Typwithoutname/VMCB/Git-Guide.txt

Wichtigster Befehl: "git status"

1.Projekt auf deinen PC clonen

-In den Ordner gehen in das du Clonen willst
-Linksclick "Git Bash"

-Commando eingeben "git init"
-"git pull https://github.com/Typwithoutname/VMCB"

Jetzt sollte das Projekt im localen Ordner sein

--------------------------------------------------------

2.Die Githubseite updaten
-In den Ordner gehen den du updaten willst
-Linksclick "Git Bash"

-"git add --all"
-"git commit"
VIM
"i" drücken dann kann Text eingefügt werden
Text eingeben
drücke "ESC" 
Eingeben von ":x"

-"git add -u"
-"git push https://github.com/Typwithoutname/VMCB"

--------------------------------------------------------

3.Lokales Projekt updaten
Bevor du anfängst immer das hier machen
-In den Ordner gehen den du updaten willst
-Linksclick "Git Bash"

-"git pull https://github.com/Typwithoutname/VMCB"
