Typwithoutname/VMCB/Endpräsentation.pptx

- Stimmungsampel

## Slide 2

- Gliederung

- Projektvorstellung
- STM32G031J6M6
- LED‘s
- Kapazitiver Sensor
- Energiesparmodus
- Schaltplan und Layout

## Slide 3

Vorlagen PPT der OTH Regensburg - Format 16x9

- Funktionalität

## Slide 4

- STM32G031J6M6

- Was kann er?
- Core: ARM 32-Bit Cortex –M0+ CPU
- Power: 1.7 to 3.6V
- 4 oscillator
- DMA controller
- ADC
- 11 timers
- communication interfaces

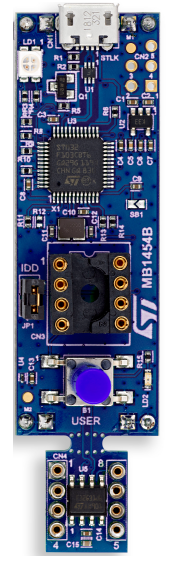
[picture p11: figure]

## Slide 5

- LED‘s

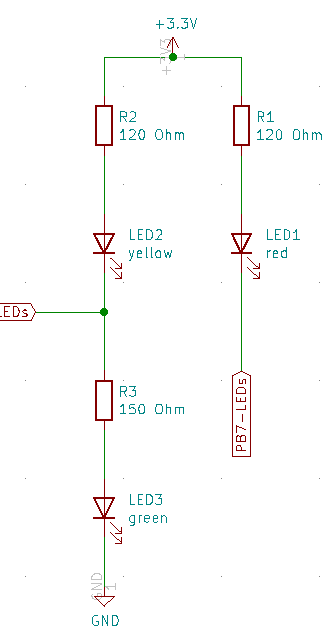
[picture p12: figure]

- RGB-LED‘s
- WS2812b
- Versorgung 5V -> Boost Converter
- DMA Auslesung
- PWM Ansteuerung seriell
- Led-Schaltung
- Ansteuerung mehrerer LED‘s mit wenig Pins

1

2

## Slide 6

- Funktionalität kapazitiver Sensor mit Gehäuse

## Slide 7

- Schaltplan

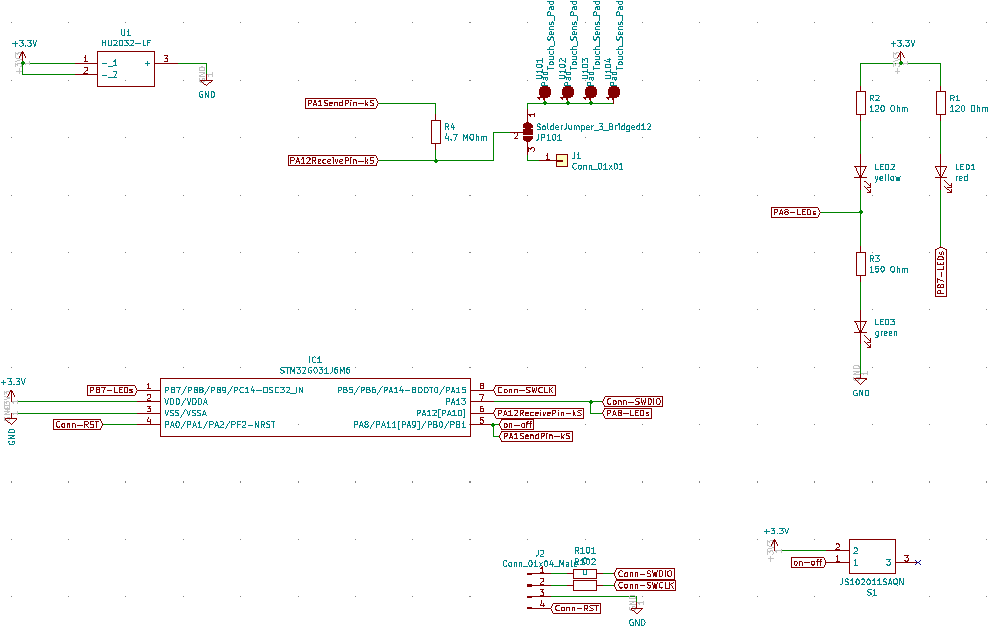
[picture p13: figure]

Batterieversorgung

Kapazitiver Sensor

LED-Schaltung

Mikrocontroller

Schalter für Lowpowermode

Connector zum Debuggen

## Slide 8

- Layout – Bauteile

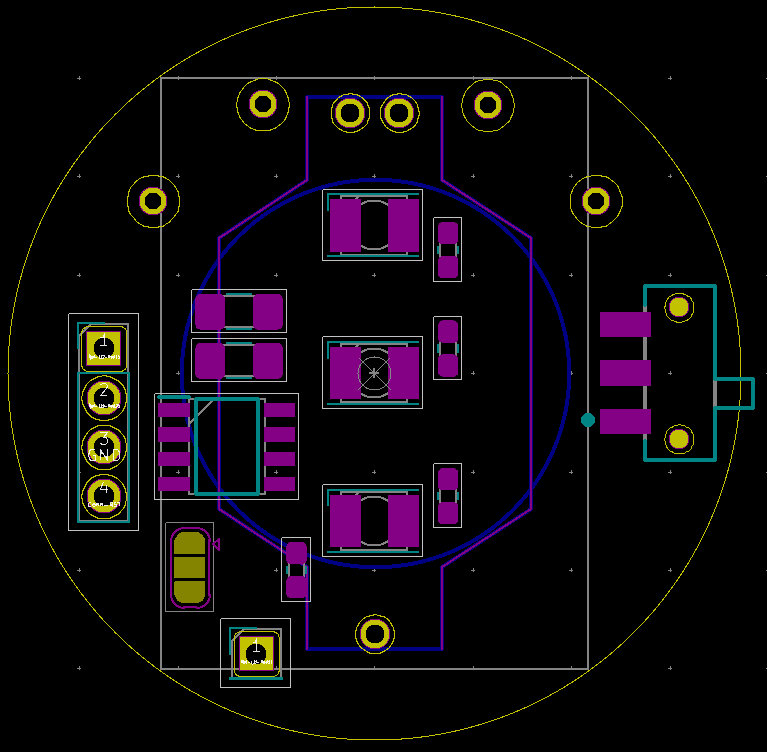
[picture p14: figure]

Batterieversorgung
Mikrocontroller
Connector zum Debuggen
Schalter für Lowpowermode
Kapazitiver Sensor
LED-Schaltung

## Slide 9

- Layout

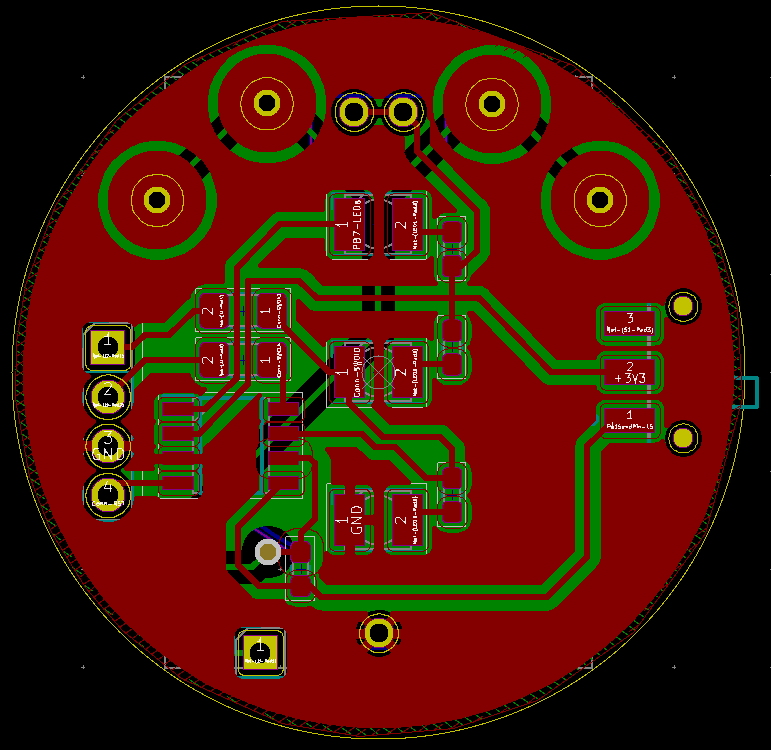
[picture p15: figure]
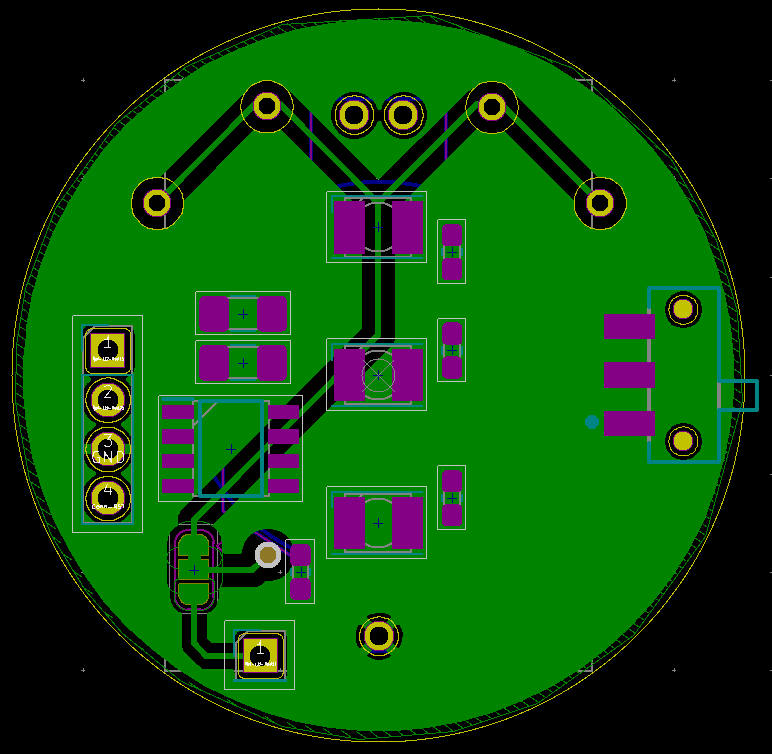
[picture p16: figure]

## Slide 10

- Gefräste Platine

## Slide 11

- Gehäuse

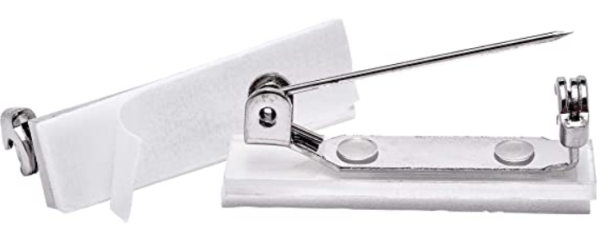
[picture p17: figure]
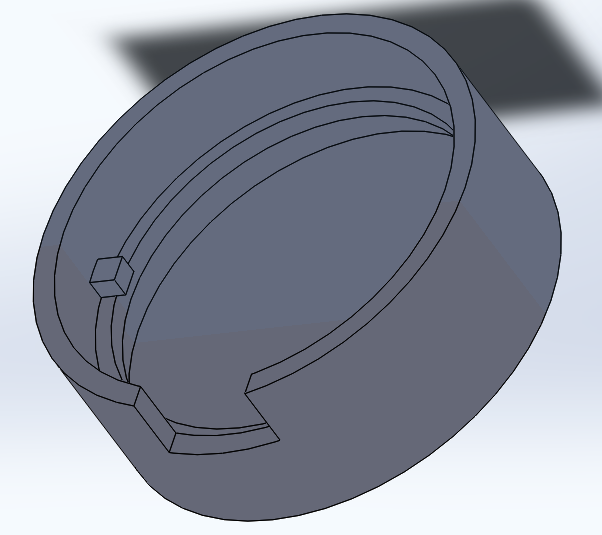
[picture p18: figure]
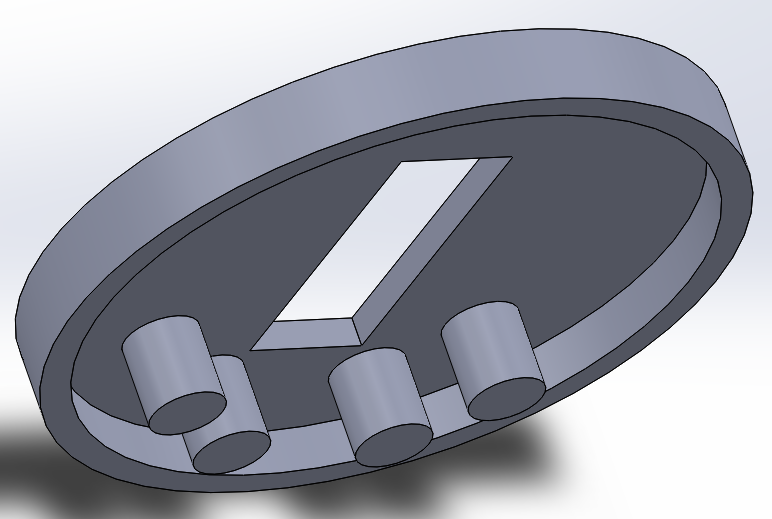
[picture p19: figure]

## Slide 12

- Gedrucktes Gehäuse
