Typwithoutname/VMCB/Doku/AblaufMain.docx

Nein

Nein

Nein

Ja

Ja

Ja

Weiterschalten LED-Zustand

Berührung festgestellt?

Stoppen des Energiesparmodus

Energiespar-modus noch an?

Auslesen von Kapazitiver Sensor

Einschalten des Energiesparmodus

Energiesparmodus an?

Init

Start
