Typwithoutname/VMCB/Doku/Zustandsdiagramm.docx

Schalter Aus

Schalter Aus

Schalter Aus

Schalter Aus

Schalter An

Schalter An

Schalter An

Schalter An

Berührung

Berührung

Berührung

Berührung

Energiesparmodus – LED-Grün

Energiesparmodus – LED-Gelb

Energiesparmodus – LED-Rot

Energiesparmodus – Keine LED

Keine LED

LED-Rot

LED-Gelb

LED-Grün
