Typwithoutname/VMCB/Doku/BA.pdf

714

1

# Stimmungsampel

### Luzia Pfeilschifter und Felix Maier

### 30. Dezember 2020

2

Zusammenfassung

Das Ziel des Projektes war es ein minimalistisches Gerät mit dem STM32G031-Microcontroller zu entwickeln, welches die Stimmung des Trägers mithilfe von LED’s darstellt und dabei party-tauglich ist. Aus diesem Vorgaben ist das entwickelte Gerät entstanden. Es wird mit einer Knopfzelle betrieben und lässt sich durch eine Beruhrung ¨ mit dem Finger an der Vorderseite des Gehäuses zyklisch, wie eine normale Ampel, weiter schalten. Dies wird durch einen kapazitiven Sensor ermöglicht. Außerdem ist noch ein Schalter verbaut, der die ”

Stimmung“ einrasten lässt um beispielsweise ein versehentliches Weiterschalten beim Tanzen zu verhindern. Zudem ermöglicht dieser Schalter eine Reduktion des Stromverbrauchs, wodurch der Partyspaß noch länger anhält.

3

## Inhaltsverzeichnis

1 Funktionsweise | 5
2 Microcontroller | 7
3 LED | 9
3.2.2 | grune LED | ¨ | 11
3.3 Auswahl der Widerstände fur die LED-Schaltung | ¨ | 12
4 Kapazitiver Sensor | 14
5 Energiesparmodus | 18
6 Schaltplan und Layout | 19
7 Gehäuse | 25
8 Fazit | 30

4

## 1 Funktionsweise

Die Funktionsweise werden durch die Abbildung 1 und 2 dargestellt.


Abbildung 1: Flussdiagramm zum Ablauf des Hauptprogramms

5


Abbildung 2: Zustandsdiagramm

6

## 2 Microcontroller

7


Abbildung 3: STM32G031J6M6 als SMD-Baustein QUELLE

Das Projekt wurde mit dem STM32G031J6M6 (Abbildung 3) umgesetzt. Dies ist ein 8-Pin Microcontroller mit einer ARM 32-Bit Cortex–M0+ CPU, der sehr wenig Strom verbraucht und damit perfekt fur diesen Einsatzbereich ¨ ist. Er kann mit 1.7 V bis 3.6 V betreiben werden, was gut fur die Versorgung ¨ mit eine Knopfzelle ist.
Zudem verfugt er ¨ uber 4 Oszillatoren, einen DMA-controller, einen ADC, 11 ¨ Timer und verschiedene Kommunikationsinterfaces, was völlig ausreichend fur dieses Projekt ist QUELLE. ¨
Dieser Mikrocontroller hat aber auch Nachteile: Einerseits die Pin-Knappheit, da nur 6 Pins programmiert werden können, was die Komplexität der Außenbeschaltungen einschränkt. Die Pinbelegung zeigt hierbei Abbildung 4.
Andererseits kann es schwer sein diesen Microcontroller zu debuggen bzw. zu flashen, da die Pins 7 und 8 umprogrammiert werden können und somit
nicht mehr fur der Debug- bzw. Flashvorgang zur Verf ¨ | ugung stehen. Dieses ¨
Problem wurde mithilfe des Programmes STM32 ST-LINK Utility, welches eine ”

Connect under Reset“-Option besitzt, gelöst. Dabei wird der Controller in den Reset-Zustand gebraucht. Beim Austreten aus diesen Zustand verbindet es sich mit dem Mikrocontroller bevor der bereits bestehende Code ausgefuhrt wird, was es erlaubt den Baustein neu zu programmieren. ¨

Abbildung 4: Pinbelegung des Mikrocontrollers STM32G031J6M6 QUELLE

8

## 3 LED

### 3.1 WS2812b

Als nächstes wird die Möglichkeit betrachtet eine WS2812b-LED zu verwenden. Sie hat von allen bisherigen LED’s die größte Variation an Farben, die dargestellt werden können. Die Ansteuerung erfolgt außerdem nur uber eine ¨ Datenverbindung, was bei einem Mikrocontroller mit nur 8 Pins sehr vorteilhaft ist.
Die verschiedenen Ubertragungsbit k ¨ | önnen dabei als PWM-Signale mit un-
terschiedlichen Duty-Cycle aufgefasst werden. So hat eine logische ”
| 0“ ein
Duty-Cycle von 32% und eine logische ”
| 1“ ein Duty-Cycle von 68%.
Daraus können GRB-Werte gebildet werden, welche durch ein DutyCycle
von 0% uber mindestens 50 ¨ | µs von den LED’s ubernommen werden. Die- ¨
ser komplette Vorgang ist sehr aufwändig fur den Prozessor. Deshalb wird ¨ der im Mikrocontroller eingebaute DMA-Controller, was fur ¨
| ” Direct Memo-
ry Access“ steht, verwendet, um die Auslastung des Prozessors signifikant zu verbessern.
Die WS2812b LED hat aber insgesamt zwei große Nachteile, die sie schlechter als andere Varianten macht. Zum einen die hohen Kosten, was mit dem Ziel einen möglichst preiswerten Aufbau zu entwerfen kollidiert. Und zum anderen benötigt sie Spannungsversorgung von 5 V, was einen Hochsetzsteller erfordern wurde, da der komplette Aufbau mit einer Knopfzelle betrieben ¨ wird.

9

### 3.2 LED-Schaltung


Abbildung 5: LED Schaltung

Letztendlich war eine Schaltung, die mit möglichst wenig Pins möglichst viele LED’s ansteuert am sinnvollsten. Um dies zu ermöglichen wurde eine Schaltung entworfen, die mit Hilfe von Input und Output die LED’s steuert. Dabei können bis zu 4 LED’s mit 2 Pins angesteuert werden. In der vorliegenden Ampelschaltung sind nur 3 LED’s notwendig, allerdings könnte die 4. noch zwischen Ground und LED1 gehängt werden, wie parallel dazu LED3. Also gibt es 4 verschiedene Zustände, die im folgenden erklärt werden:

10

### 3.2.1 keine LED leuchtet

Der Pin ”

PA8-LEDs“ wird als Input deklariert, so fließt im linken Zweig kein Strom. Wenn nun auch noch ”

PB7-LEDs“ auf Input gesetzt wird, wird auch dieser Pin hochohmig und im rechten Zweig fließt kein Strom. Wenn weder im linken noch im rechten Zweig ein Stromfluss entsteht sind alle LED’s aus.

### 3.2.2 grune LED ¨

Indem der Pin ”

PA8-LEDs“ als Output auf ”
HIGH“ gelegt wird, fließt Strom zwischen ”

HIGH“ und Ground → LED3 leuchtet. Um die rote LED nicht zu aktivieren, wird ”

PB7-LEDs“ als Input gesetzt und wiederum hochohmig. Die gelbe LED leuchtet nicht, da kein Spannungsfall zwischen 3.3 V und

”

PA8-LEDs“ vorhanden ist.

### 3.2.3 gelbe LED

Um die gelbe LED2 leuchten zu lassen wird nun der Pin ”

PA8-LEDs“ als
Output auf ”

LOW“ gesetzt. Die Folge ist, dass Strom zwischen 3.3 V und

”

PA8-LEDs“ fließt → LED2 leuchtet. Um zu erreichen, dass auch nur LED2 leuchtet wird ”

PB7-LEDs“ als Input gesetzt und somit hochohmig → im rechten Zweig fließt kein Strom.

### 3.2.4 rote LED

Der Pin ”

PB7-LEDs“ wird als Output auf ”

LOW“ gesetzt. Dadurch fließt ein Strom zwischen 3.3 V und dem Output ”

LOW“ → LED1 leuchtet. Damit die anderen LEDs nicht leuchten, wird ”

PA8-LEDs“ auf Input gesetzt, dadurch wird er hochohmig und im linken Zweig fließt kein Strom.
Dies ist in der folgenden Tabelle 3.2.4 noch einmal zusammenfassend dargestellt.
Leuchtet | Zustand | PA8-LEDs | PB7-LEDs
keine LED | aus | IN | IN
LED1 | grun¨ | OUT−HIGH | IN
LED2 | gelb | OUT−LOW | IN
LED3 | rot | IN | OUT−LOW

Tabelle 1: LED Schaltung Pinbelegung

11

### 3.3 Auswahl der Widerstände fur die LED-Schaltung ¨

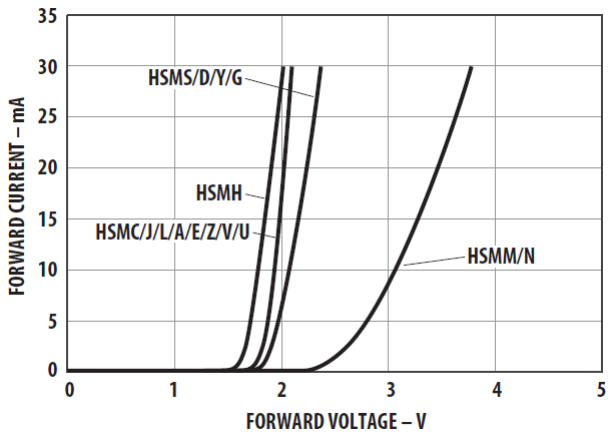
[picture p25: figure]

Abbildung 6: Kennlinien forward current vs. forward voltage der unterschiedlichen SMD-LED’s [1]

Anhand dem Bestand im Labor der OTH, fiel die Entscheidung auf die Widerstandsreihe R0603. Auch die Auswahl der LED’s erfolgte nach diesem Kriterium fur die HSMx-A100-Reihe von Avago. ¨
Hierbei ergeben sich aus dem Datenblatt unterschiedliche forward voltage fur ¨ die jeweilige Leuchtfarbe. Die Berechnung der Widerstände erfolge allerdings immer nach demselben Prinzip. Dabei wurde zunächst die jeweilige forward voltage ermittelt und anschließend mit der Batterieversorgung von 3.3 V und einem gewunschten Strom von 10 mA der resultierende Widerstand berech- ¨ net.
Die Festlegung auf 10 mA erfolgte vor allem aus Erfahrung und aus Grunden ¨ des Stromverbrauchs. Der normale Betrieb liegt bei 20 mA, dies ist allerdings recht hell und bei einer meist dunklen Party erschienen somit auch 10 mA
ausreichend, was gunstiger f ¨ | ur den Stromverbrauch ist. ¨

12

Bei der roten LED1 handelt es sich um eine HSMS-A100-J00J1. Mit dieser Information lässt sich die entsprechende Kennlinie und damit die resultierende forward voltage von 2.1 V ermitteln. Die folgende Berechnung fur den ¨ Vorwiderstand ist also:

R1 = (3.3 − 2.1)V/10mA = 120Ω

Als letztes muss noch uberpr ¨ uft werden, ob dieser Wert auch innerhalb der ¨ R0603-Reihe vorhanden ist oder ob ein naheliegender Wert gewählt werden muss. Da allerdings 120 Ω vorkommen, kann der exakte Wert fur die Schal- ¨ tung verwendet werden.

Die selben Schritte erfolgen nun auch fur die weiteren LED’s, wodurch sich ¨ fur die gelbe LED2 (HSMY-A100-J00J1) dieselbe forward voltage ergibt. ¨ Dadurch ist nun die Berechnung gleich der Rechnung fur die rote LED: ¨

R2 = (3.3 − 2.1)V/10mA = 120Ω

Und auch hier kann direkt der richtige Wert aus der Reihe genommen werden.

Zum Schluss noch zur grunen LED3, dem Bauteil HSME-A100-L01J1. Hier ¨ lässt sich eine forward voltage von 1.8 V aus dem Diagramm ablesen. Dadurch ergibt sich fur den Widerstand: ¨

R3 = (3.3 − 1.8)V/10mA = 150Ω

Nach der Reihe R0603 ergibt das auch einen Widerstand von 150 Ω.

13

## 4 Kapazitiver Sensor

Als nächstes wird der Kapazitive Sensor erläutert, der fur die Weiterschaltung ¨ der LED’s zuständig ist. Grundsätzlich ist zu sagen, dass alle Kapazitiven Sensoren auf einem RC-Oszillator basieren. Kommt es zu einer Beruhrung ¨ oder Näherung durch beispielsweise einem Finger so wird die Kapazität und somit die Lade- und Entladezeit des Oszillators erhöht. Es gibt verschiedene Möglichkeiten dies zu detektieren. Nachfolgend sind einige davon aufgelistet, die fur das Projekt in Betracht gezogen wurden. ¨

### 4.1 Verschiedene Varianten von Kapazitiven Sensoren

### 4.1.1 Komparator

Zuerst wird die Komparator-Methode erklärt. Hierbei wird ein Dreieck-Signal an einem RC-Ladeglied angelegt. Durch das RC-Glied wird das Signal abgerundet ähnlich wie in Abbildung ?? zu sehen. Dieses Signal und eine feste Gleichspannung wird nun an einen Komparator angelegt. Jedes Mal wenn der Komparator umschaltet wird die vergangene Zeit gemessen. Gibt es
eine Beruhrung so wird das Dreieck-Signal st ¨ | ärker abgerundet und somit
verändert sich auch die Zeit die der Komparator zum Umschalten braucht. Durch dieses Prinzip können auch relativ elegant Timer und Interrupts verwendet werden.

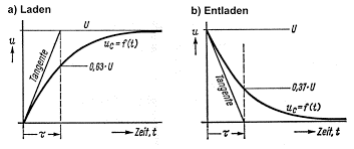
[picture p26: figure]

Abbildung 7: RC-Tiefpass

14

### 4.1.2 ADC

Als nächstes wird die Variante erklärt, die einen Analog-Digital-Wandler verwendet. Hierbei wird ein RC-Ladeglied auf den logischen High-Pegel aufgeladen und nach einer festen Zeit mithilfe des ADC gemessen. Die gemessene Spannung ist dabei abhängig von der Kapazität des Ladeglieds. Ist die
Kapazität nicht erhöht, also keine Beruhrung oder N ¨ | äherung von zum Bei-
spiel einem Finger, so entlädt sich die Spannung schneller. Gibt es aber eine
Beruhrung oder N ¨ | äherung so ist die Kapazität höher und die Entladekon-
stante des RC-Glieds größer, was zu einem zeitlich längeren Spannungsabfall
fuhrt. Zusammengefasst ist also die Spannung, die der ADC misst gr ¨ | ößer
wenn eine Beruhrung oder N ¨ | äherung statt gefunden hat.

### 4.1.3 Sende- und Empfangspins

Die dritte Variante ist jeweils einen Sende- und Empfangspin zu benutzen. Dabei wird ein sehr hochohmiger Widerstand zwischen zwei Pins gesetzt, der mit der Kapazität des Receivepins ein RC-Tiefpass realisiert. Verändert man nun den Logik-Pegel am Sendpin so dauert es, wegen dem Tiefpass, eine kurze Zeit bis diese Anderung am Receivepin ankommt. Diese Zeit ist messbar und ¨ je nach Kapazität unterschiedlich. Die unterschiedliche Kapazität ist auf ein
Metallstuck oder Folie, welches am Receivepin befestigt ist, zur ¨ | uckzuf ¨ | uhren. ¨
Beruhrt man diese Folie so wird, wie bei der ADC-Variante, die Ladekonstan- ¨ te erhöht und es dauert länger bis eine Anderung des Sendpins am Receivepin ¨ erkannt wird. Dieser Aufbau ist im Abbildung 8 veranschaulicht.


Abbildung 8: Funktionsweise des Kapazitiven Sensors

15

### 4.2 Bewertung

Als nächstes werden die Varianten aus 4.1 bewertet. Die erste Lösung ist hier sehr umständlich umzusetzen, da der Mikrocontroller STM32G0316J6M6 keinen Komparator besitzt. Deswegen wurde diese Variante nicht verwendet. Die ADC-Methode hat den großen Vorteil, dass sie nur ein Pin benötigt. Sie braucht jedoch eine zusätzliche Kapazität, was Platz verbraucht und Kosten verursacht. Zudem besitzt der Mikrocontroller nur einen Analog-Digital-
Wandler, welcher gegebenenfalls anderweitig fur einen Sensor h ¨ | | ätte verwen-
det werden können. Die letzte Variante ist auch die Einfachste. Sie braucht nur einen Widerstand und hat keine besonderen Anforderungen an die Hardware des Mikrocontrollers. Der größte Nachteil ist hier allerdings, dass zwei Pins benötigt werden. Pins können aber trotzdem mehrfach verwendet werden, was in 5 näher erklärt wird. Letztendlich wurde sich fur die Sende- und ¨ Empfangsmethode entschieden.

### 4.3 Umsetzung

Dieser Abschnitt beinhaltet die Umsetzung der Variante, welche unter 4.2 ausgewählt wurde. Grundsätzlich ist zu sagen, das der Sensor in der jetzigen Form sehr ungenau und unzuverlässig ist. Um dies zu ändern und eine auswertbare Messung zu erhalten muss der Vorgang mehrfach hintereinander durchgefuhrt werden, damit eventuelle Fehlerquellen ermittelt und behoben ¨ werden können.
Ein großes Problem ist zudem, dass der Receivepin nach einer einzelnen Messung nicht auf einen vollen HIGH- bzw. LOW-Pegel aufgeladen wird, was
schlecht fur die n ¨ | ächste Messung wäre.
Der Receivepin meldet also einen HIGH-Pegel schon bei beispielsweise 1.8
V, was das Ende der Messung bedeuten wurde, obwohl f ¨ | ur den n ¨ | ächsten
Zyklus 3.3 V an diesem Pin benötigt werden. Deswegen wird der Pin danach als Output deklariert und der entsprechende Pegel angelegt bis dort die 3.3 V bzw. 0 V anliegen. Zusätzlich werden Pullup- und Pulldownwiderstände genutzt um diesen Prozess zu beschleunigen.
Zu Beginn des Projektes wurde der Kapazitive Sensor mit einem Metallteil, welches mit einem Kabel verbunden ist, ausgetestet, was gut funktioniert hat. Nur fur eine kompakten und vor allem einfachen Aufbau ist dies groß ¨ bzw. zu kompliziert zu erstellen. Deswegen wurde auf ein bereits bestehen-
des Metall zuruckgegriffen n ¨ | ämlich das Kupfer der Platine. Es wurden vier
kreisförmige Flächen angelegt, die den Designrules ??von STM entsprechen. Dadurch könnte auch ohne externes Metallteil eine Beruhrung erkannt wer- ¨ den.

16

Ein weiterer wichtiger Punkt ist die Größe des Widerstandes, da dieser der Sensitivität des Sensors entspricht. Bei einem Widerstand von beispielsweise 1 MOhm wird nur ein direkter Kontakt erkannt. Wird dieser erhöht so kann auch eine Näherung oder Kontakt uber eine kurze Luftlinie bzw. durch ¨ ein anderes Material gemessen werden. Dieses Konzept wurde auch bei diesem Projekt umgesetzt, da auch durch das Gehäuse eine Beruhrung erkannt ¨ werden soll. Deswegen wurde ein 4,7 MOhm Widerstand verwendet. Außerdem wurde das Gehäuse so angepasst, dass die herausstehenden Zylinder die Kupferflächen des Sensors und das Gehäuse direkt verbinden. Ein großer Luftspalt zwischen diesen beiden Komponenten wurde es hier sehr schwierig ¨ machen einen Kontakt zu unterscheiden. Aus dem selben Grund wurde auch noch Sekundenkleber verwendet.
Bei der Pinbelegung wurden zuerst Pin 4 und 5 gewählt. Der Grund dafur ¨ war das die Pins des Mikrocontrollesr, welche fur die Single-Wire-Debug- ¨ Schnittstelle zuständig sind unbenutzt bleiben sollten um das debuggen zu ermöglichen. Das Problem hieran war, dass der Pin 4 der Reset-Pin ist und teilweise beim testen eine Stuck-at-1-Fehler aufwies. Dies ließ den Mikrocontroller im Reset-Zustand verweilen, was den Ablauf des Programmes und das Debuggen verhinderte. Deswegen wurde der Kapazitive Sensor auf Pin 5 und 6 gelegt.

### 4.4 Störquellen und Probleme

Schlussendlich muss leider gesagt werden, dass einige Probleme nicht perfekt gelöst werden konnten. Einer ist das weiter schalten des Zustandes ohne
Masseverbindung. Der Grund dafur ist, dass ¨ | uberall andere elektromagne- ¨
tische Begebenheiten herrschen, die eine Masseverbindung abfangen wurde. ¨ Dadurch ist auch die Zeit, die der Empfangspin zum erkennen benötigt und
damit der Schwellenwert fur die Ber ¨ | uhrungsentscheidung anders. Deswegen ¨
ist der kapazitive Sensor ohne Masseverbindung relativ unzuverlässlich. Die Lösung dafur w ¨ äre ein dynamischer Schwellenwert. Dies wurde aber vom ¨ Aufwand her die Vorgaben weit uberschreiten. ¨
Außerdem wurde festgestellt, dass sich das System selbst beeinflussen kann. So ist es möglich bei eingeschalteter Gelben-Led und Anwesenheit eines Gehäuses ein Sensor-Timeout hervorzurufen. Ein Sensor-Timeout heißt hier, dass der Empfangspin des Sensors sich zu langsam oder gar nicht ändert. Dieses Problem konnte nicht näher betrachtet werden, da es keine kurzfristige Möglichkeit gab ein Oszilloskop anzuschließen.

17

## 5 Energiesparmodus

Als nächstes sollen die verschiedenen Möglichkeiten Strom zu sparen betrachtet werden. Der simpelste Ansatz wäre hier ein PWM-Signal fur die LED’s ¨ zu benutzen, um so Strom einzusparen. Diese Variante ist bei der verwendeten LED-Schaltung aber nicht ganz einfach, da man Extra-Pins fur die ¨ Versorgung bräuchte.
Eine weitere Möglichkeit ist der LowPowerMode des Mikrocontrollers. In diesem Modus wird wesentlich weniger Strom verbraucht als normal und es gibt keine Anderung der Output-Pins. Dadurch kann auch ein Lock-Mechanismus ¨ fur den Kapazitiven Sensor realisiert werden. Der LED-Zustand kann also ¨ nicht verändert oder weiter geschaltet werden. Dies ist nutzlich um eine ver- ¨
sehentliche Anderung, durch Ber ¨ | uhren oder St ¨ | örungen, zu verhindern. Um
in diesem Zustand hinein und wieder herauszukommen wird ein Schalter benutzt der den ReceivePin des Kapazitiven Sensor also Pin 5 benutzt. Wird dieser geschaltet so entsteht eine Verbindung zwischen Pin 5 und Vcc und der Code geht in den Energiesparmodus. Generell werden durch diese Anordnung keine Extra-Pins benötigt. Ein Grund dafur ist, das die Verbindung ¨ zu 3.3 V zyklisch abgefragt wird.
Der Stromverbrauch der einzelnen Zustände wurde letztendlich gemessen und in Tabelle 5 dargestellt.
Normalbetrieb | 7,6mA
Energiesparmodus mit LED | 6,2mA
Energiesparmodus ohne LED | 0,24mA

Tabelle 2: Stromverbrauch unterschiedlicher Modi

18

## 6 Schaltplan und Layout

Die Gestaltung der Platine setzt sich zusammen aus der Erstellung des Schaltplans, nach den zuvor ermittelten Funktionen. Das Layout wird anhand des Schaltplans erstellt und mit den gegebenen Vorgaben fur die ¨ äußere Erscheinung der Ampel. Beides erfolgt mit dem Programm KiCAD, fur das im Vor- ¨ feld ein Einfuhrungskurs an der OTH besucht wurde. ¨

### 6.1 Schaltplan

Als erstes wird der Schaltplan in 6 verschiedene Teile unterteilt um das Folgende ubersichtlicher zu gestalten. Diese Teile sind: Batterieversorgung, ¨ kapazitiver Sensor, LED-Schaltung, Energiesparmodus-Schalter, Connector, Mikrocontroller

Batterieversorgung

Da es sich um ein möglichst minimalistisches System handelt, ist ein Knopfzellenbetrieb notwendig. Eine passende Batteriegröße dafur ist 3032 und ¨ es gibt unterschiedliche Batteriehalter fur eine solche Batterie. Aus diesem ¨ Grund wurde der Batteriehalter nach einem passenden Package fur KiCAD ¨ ausgewählt, da das fur die Layouterstellung einfacher ist. Die Wahl viel somit ¨ auf ein Modell von Renata.
Der Batteriehalter befindet sich in der linken oberen Ecke von Abbildung 9. Das Package war von den +/- Belegungen vertauscht, was allerdings später beim Layout entdeckt wurde.

kapazitiver Sensor

Der kapazitiver Sensor (Abbildung 9 oben mittig) wurde wie nach Kapitel 4.1.3 mit einem Sende- und Empfangspin realisiert. Sie sind an Pin 5 und 6 des Mikrocontrollers angeschlossen. Als nächstes wurde ein Jumper eingesetzt um die Möglichkeit offen zu halten den kapazitiven Sensor entweder mit Pads oder einem Connector zu verbinden. Der Connector war als gesicherte Methode gedacht, bei der eine Metallplatte angeschlossen wird als Sensor. Dies war später allerdings nicht notwendig, da der Sensor mit den Pads funktioniert hat und deshalb wurde auch ein Widerstand von 4.7 MOhm ausgewählt, der dazu passt.

19

LED-Schaltung

Die LED-Schaltung (Abbildung 9 oben rechts) ist an dieser Stelle recht simpel zu erklären, da auf die Hintergrunde ihrer Entstehung bereits in Kapitel ¨ 3.2 eingegangen wurde. Die Pins des Microcontrollers wurden danach ausgesucht, dass es sich dabei nicht um Debug-Pins handelt und aus diesem Grund wurden Pin 5 und 6 gewählt.

Energiesparmodus-Schalter

Es wurde ein Schalter (Abbildung 9 unten rechts) ohne Durchkontaktierung ausgewählt (JS102011SAQN von C & K Components). Der Schalter soll dabei die funktionierende Schaltung nicht beeinträchtigen, aber den Energiesparmodus aktivieren. Aus diesem Grund ist der dritte Kontakt des Schalters nicht angeschlossen und ermöglicht den normalen Betrieb. Wenn der Schalter ”

aktiviert“ ist, ist er uber Pin 5 mit dem Mikrocontroller verbunden und ¨ dadurch wird der Energiesparmodus eingeschaltet.

Connector

Der Connector (Abbildung 9 unten mittig) ermöglicht lediglich den Mikrocontroller mit dem entsprechenden Code zu bespielen. Es ist die einfachste Möglichkeit den Mikrocontroller mit dem USB-Stick ST-Link V2 zu programmieren. Die minimale Anzahl an Pins ist hierbei 4 fur Ground, Reset, ¨ SWCLK und SWDIO.

Mikrocontroller

Der Mikrocontroller (Abbildung 9 mittig) ist zum einen mit Ground und 3.3 V von der Batterie verbunden. Eine weitere Belegung von Pin 4 und 8 fuhrte ¨ zu Fehlern, aus diesem Grund werden nur die anderen Pins uberbelegt. Dies ¨ war notwendig, da der Microcontroller lediglich 8 Pins zur Verfugung stellt ¨
und bereits 4 wegfallen. Die ubrig gebliebenen 4 m ¨ | ussen also 6 Funktionen ¨
ausfuhren. Das Package f ¨ | ur den Mikrocontroller konnte f ¨ | ur KiCAD herun- ¨
tergeladen werden.

20

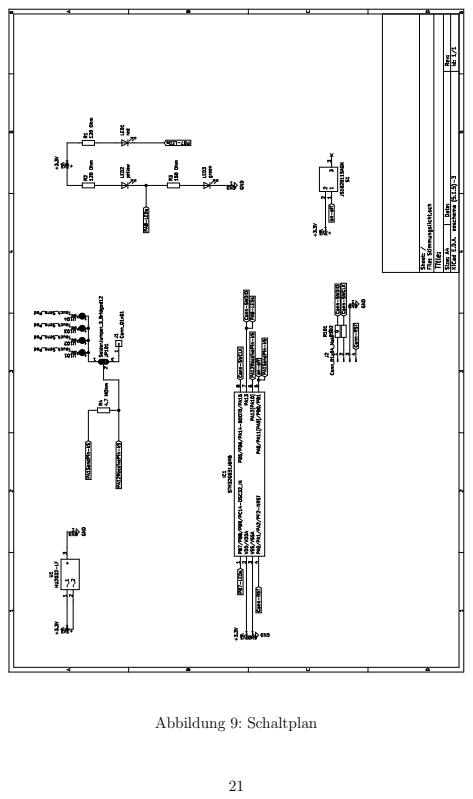
[picture p27: page 21]
Abbildung 9: Schaltplan

### 6.2 Layout

Das Layout wird anhand des Schaltplans mit KiCAD erstellt, dabei werden die entsprechenden Bauteile ausgewählt und dann in PCB uberliefert. Als ¨ erstes wird der Umriss der Platine als Kreis erstellt mit einem Durchmesser von unter 4 cm. Es mussen auch die Leitungsparameter festgelegt werden, ¨ die so ausgewählt wurden, dass eine Fräsung bei der OTH möglich war. Also breiter als normalerweise bei dem vorhandenen Strom notwendig gewesen wäre. Nun gilt es die Bauteile zu platzieren und die Leitungen zu ziehen. Die im Folgenden beschriebenen Teile sind in Abbildung 10 fur den Front-Layer ¨ und in Abbildung 11 fur den Back-Layer ersichtlich. ¨

Batterieversorgung

Es ist wenig Platz auf der Platine vorhanden, deshalb ist der Batteriehalter auf der Ruckseite platziert. Man kann seine Durchkontaktierungen oben ¨ doppelt und unten als einen Kontakt in den Abbildungen 10 und 11 erkennen.

LED-Schaltung

Die LED’s wurden als nächstes mittig platziert, da sie die Ampelschaltung anzeigen. Alle anderen Bauteile werden um sie herum platziert.

Energiesparmodus-Schalter

Der Schalter fur den Energiesparmodus ist seitlich direkt am Rand der Pla- ¨ tine platziert, damit er von außen bedient werden kann.

Mikrocontroller

Da die meisten Leitungen zum Mikrocontroller fuhren ist es sinnvoll diesen ¨ möglichst mittig zu platzieren um lange Leitungen zu vermeiden. In diesem Fall bedeutet das allerdings nur so mittig wie möglich, da sich die LEDs bereits dort aus optischen Grunden befinden. ¨

Connector

Der Connector befindet sich möglichst neben dem Mikrocontroller damit die Leitungen nicht zu lang werden.

22

kapazitiver Sensor

Der kapazitive Sensor erhielt sozusagen den ubrig gebliebenen Platz. Da die ¨ Sensorflächen äußerst groß sind und nicht zu nah an den Connectoren, aufgrund von Störungen, platziert werden sollten, ist der einzige Platz oberhalb der LED’s.
Dies ist nur die erste Hälfte des Sensors. Der Connector muss möglichst weit am Rand sein, da der Draht, der nach Außen zu einer Metallplatte fuhrt ¨ nicht unnötig lang sein soll.
Dadurch ist es schwierig die Sensorpads an den Mikrocontroller anzuschließen, da sie weit voneinander entfernt sind. So wurde auf den Back-Layer, wie
in Abbildung 11 zu erkennen, fur die Leitungen zur ¨ | uckgegriffen. Den Pads ¨
wurde außerdem eine Durchkontaktierung hinzugefugt. ¨

Um Uberschneidungen in den Leitungen zu vermeiden wurden noch zwei ¨
zusätzliche Widerstände mit 0 Ohm hinzugefugt. Alle Leitungen laufen ¨ | uber ¨
das Front-Layer wie in Abbildung 10 zu erkennen ist. Lediglich der kapazitive Sensor wurde ruckseitig (Abbildung 11) verdrahtet. ¨
Im letzten Schritt wird die Platine als Massefläche gesetzt um Störungen zu vermeiden. Das war aufgrund der runden Form nur durch das Nachzeichnen dieser Form in KiCAD möglich.

23


Abbildung 10: Layout - Front Layer


Abbildung 11: Layout - Back Layer

24

## 7 Gehäuse

Das Gehäuse besteht aus einem Grundbehältnis und einem Deckel, welche zunächst in SolidWorks entworfen und dann mit Hilfe eines 3D-Druckers gedruckt wurden. Dabei hat sich das Gehäuse im Laufe der Projekts schrittweise weiter entwickelt. Der Deckel und der Behälter wurden in getrennten Projekten entworfen.
Die zugehörigen Abbildungen 14 und 15 wurden mit Solid Edge erstellt und zeigen die Bemaßungen des im Folgenden beschriebenen Gehäuses.

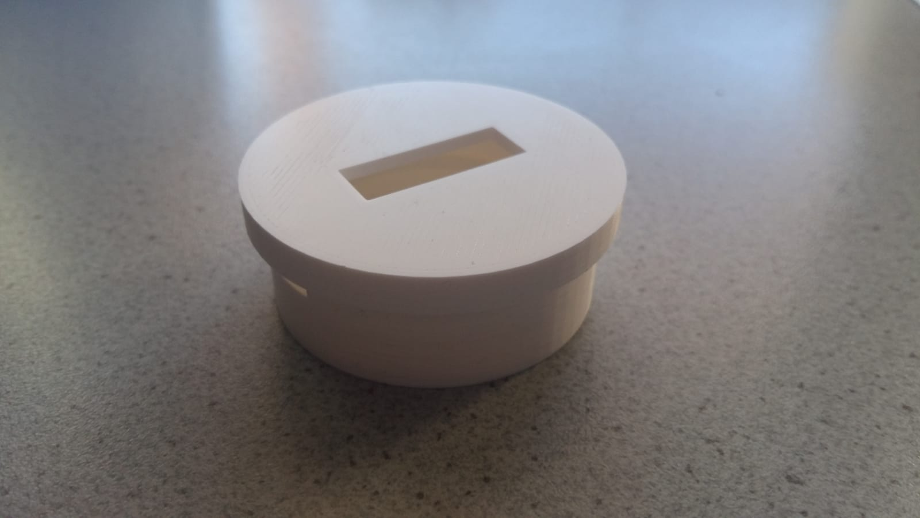
[picture p28: figure]

Abbildung 12: 3D gedrucktes Gehäuse

### 7.1 Grundbehältnis

Das Grundbehältnis wurde im ersten Schritt einfach als eine Skizze gezeich-
net, die anschließend als Rotation 360° | ausgeprägt wird. So entsteht das
Grundgerust eines nach oben ge ¨ | öffneten Hohlzylinders, der eine exakte Pas-
sung fur die runde Platine darstellt. Es wurde eine St ¨ | ärke von 2 mm fur die ¨
Außenwand gewählt.
Als nächstes ist es wichtig noch den Schalter fur den Energiesparmodus von ¨
außen bedienen zu können. Dafur ist eine Aussparung im Geh ¨ | äuse notwendig.
Am einfachsten ist es die Aussparung bis zum oberen Rand durchzufuhren. ¨

25

Die Aussparung besitzt eine Breite von 11 mm, wodurch ein 1 mm Rand auf beiden Seiten entsteht, da der Schalter eine Breite von 9 mm nach Datenblatt hat.
Die Aussparung muss allerdings an der richtigen Höhe und Stelle fur den ¨ Schalter platziert werden. Um das zu ermöglichen braucht die Platine eine Halterung, die sie im richtigen Abstand zur Aussparung hält. Die einfachste Lösung hierfur ist eine Art Ring, der innen im Hohlzylinder angebracht wird. ¨
Dafur wurde die anf ¨ | ängliche Skizze des Hohlzylinders angepasst mit einer 1.5
mm in den Zylinder hinein ragenden Kante. Diese Kante ist auf der richtigen Höhe, damit darunter noch der Batteriehalter Platz hat. Die Aussparung fur ¨ den Schalter geht dann bis knapp uber dieser Kante. ¨
Um nun auch den Schalter an der richtigen Stelle zu haben ist es nötig, dass die Platine sich nicht verdreht. Das typische Mittel dafur ist eine kleine ¨ Nut, die eine Verdrehung verhindert. Somit wurde eine kleine Nut direkt
oberhalb der Kante eingefugt, die so auf der H ¨ | öhe der Platine liegt. Die Nut
ist an der Stelle platziert, wo am meisten Platz auf der Platine vorhanden ist. Also am unteren Rand der Platine, unterhalb der Ground-Verbindung des Batteriehalters also 90° versetzt zur Aussparung des Schalters.
Nun ist die grundlegende Form des Behälters abgeschlossen.
Als letzte Verbesserung haben wir entschieden, die Connector-Pins nicht mehr nach oben anzulöten, sondern nach unten. Dadurch wird der Behälter in seiner Höhe reduziert und so handlicher und besser zu befestigen.

### 7.2 Deckel

Das Grundgerust des Deckels ist mit dem Grundbeh ¨ | ältnis identisch. Auch
der Deckel besteht aus einem einseitig geöffneten Hohlzylinder. Die Stärke des Zylinders beträgt dabei, wie zuvor, 2 mm. Zuerst muss hierfur eine Skiz- ¨ ze erstellt werden, die anschließend mit einer Rotation 360° 3D-ausgeprägt wird. Die Höhe des Zylinders ist dabei auf die Höhe des Energiesparschalters angepasst.
Im nächsten Schritt wurde der lineare Ausschnitt erstellt, der alle LED’s umfasst und somit die Sicht auf die Ampel ermöglicht. Der Ausschnitt ist zentriert und etwas größer als der Abstand der LED’s.
In der ersten Version des Gehäuses war hiermit der Deckel fertig. Es folgte jedoch eine erneute Uberarbeitung, weil ein direkter Kontakt zwischen ¨
Sensorflächen und dem Gehäuse fur die Funktionalit ¨ | ät des kapazitiven Sen-
sors notwendig war. Dafur wurden kleine Vollzylinder erstellt, die exakt an ¨ derselben Stelle positioniert sind und denselben Durchmesser haben, wie die

26

Sensorflächen. Die Höhe der Zylinder ist dabei so groß, dass wenn der Deckel sich auf dem Grundbehältnis befindet sie genau auf der Platine aufliegen.

### 7.3 Befestigung

Die Befestigung fur die Ampelschaltung soll m ¨ | öglichst einfach und leicht
reproduzierbar sein. Deshalb erschien eine Broschenadel (Abbildung 13)am
einfachsten. Diese sind gut fur die Befestigung auf H ¨ | öhe des Brustbereichs
und können in passenden Größen bestellt werden mit Klebesockel.


Abbildung 13: bestellte Broschenadel zur Befestigung [2]

27

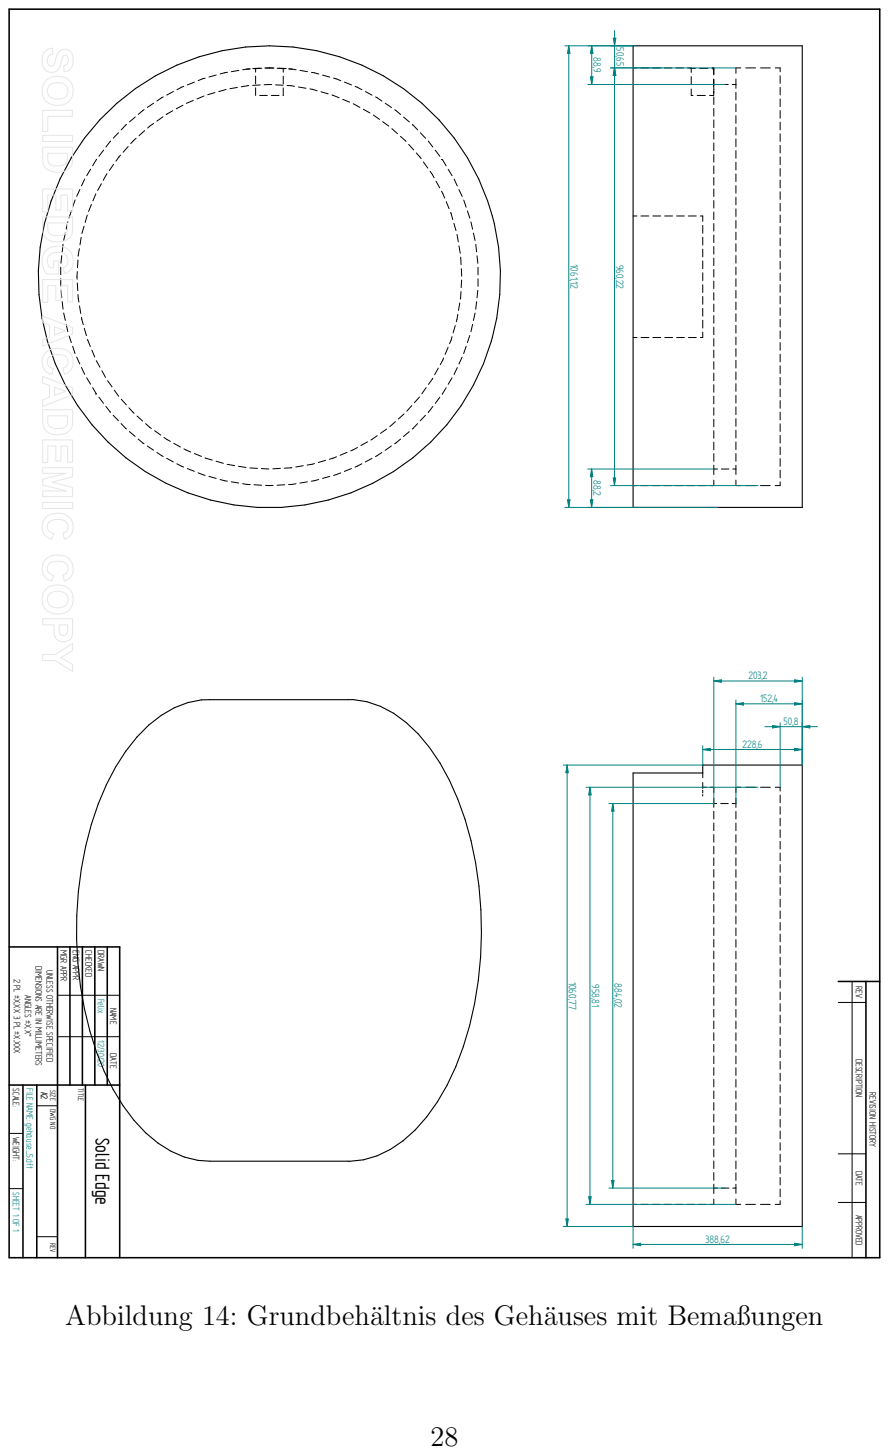
[picture p29: page 28]
MGR APPR; ENG APPR; CHECKED; DRAWN; ANGLES ±X.X°; NAME; Felix; DATE; 12/30/20 Solid Edge; TITLE; SCALE: WEIGHT:; SHEET 1 OF 1; REVISION HISTORY

DIMENSIONS ARE IN MILLIMETERS

2 PL ±X.XX 3 PL ±X.XXX

UNLESS OTHERWISE SPECIFIED

REV DESCRIPTION DATE APPROVED

FILE NAME: gehäuse_5.dft

SIZE DWG NO REV

Abbildung 14: Grundbehältnis des Gehäuses mit Bemaßungen

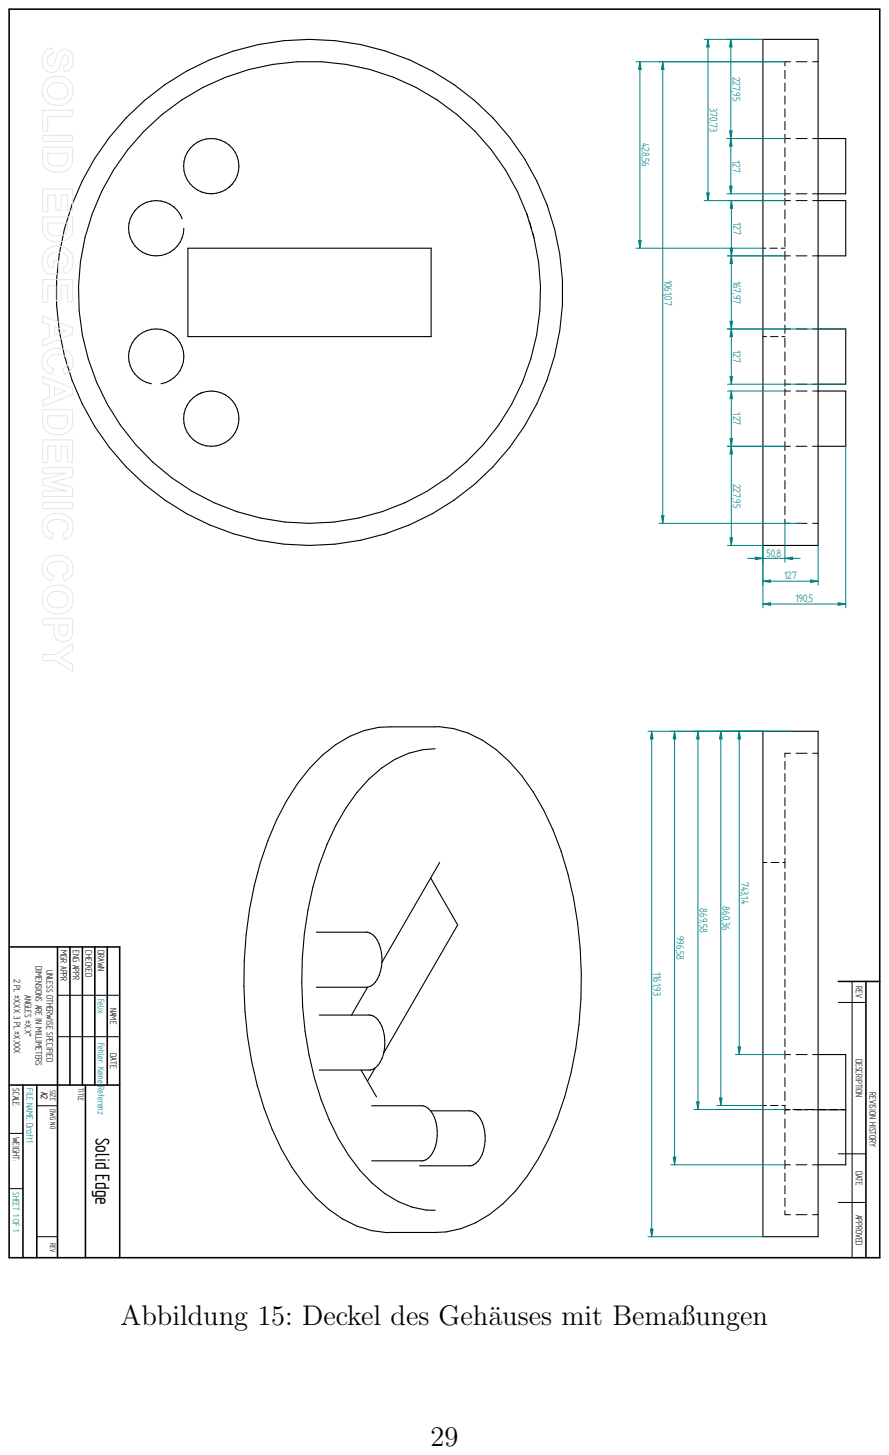
[picture p30: page 29]
MGR APPR; ENG APPR; CHECKED; DRAWN; ANGLES ±X.X°; NAME; Felix; DATE; TITLE; SCALE: WEIGHT:; FILE NAME: Draft1; SHEET 1 OF 1; REVISION HISTORY

DIMENSIONS ARE IN MILLIMETERS

2 PL ±X.XX 3 PL ±X.XXX

UNLESS OTHERWISE SPECIFIED

REV DESCRIPTION DATE APPROVED

Fehler: Keine Referenz Solid Edge

SIZE DWG NO REV

Abbildung 15: Deckel des Gehäuses mit Bemaßungen

## 8 Fazit

Insgesamt hatte das Projekt sowohl positive als auch negative Seiten.
Was den Mikrocontoller angeht, hat uns dieser viel Einarbeitung und Fehlersuche abverlangt. Dies lag vor allem daran an seiner minimalistischen Auslegung, was bei einem solchen Projekt naturlich seine Berechtigung hat. Al- ¨
lerdings war das auch die größte Hurde mit der es zu k ¨ | ämpfen galt. Eine der
größten Verzögerungen entstand durch den stuck-at-1-Fehler, dessen Hintergrund in einer einzigen Zeile im Datenblatt lag, die schwer zu entdecken war. Die Bauteilauswahl hat insgesamt gut funktioniert und die Arbeit mit den Programmen Solid Works und KiCAD war gemischt. Solid Works hat auch ohne große Einarbeitung sehr intuitiv funktioniert. Bei KiCAD lagen die größeren Probleme, trotz Einfuhrungsveranstaltung. Hierbei funktionierte die ¨ Erstellung des Schaltplans recht gut, allerdings gab es etliche Uberarbeitungen ¨ des Layouts, die viel Zeit in Anspruch genommen haben. Dies lag vor allem in der bisherigen Unerfahrenheit bei der selbstständigen Erstellung einer Platine. Mit der Zeit wurde aber auch dieses besser und es konnte einiges an Erfahrung daraus fur folgende Projekte mitgenommen werden. ¨
Ein weiteres Problem war, dass wegen der Corona-Pandemie lange keine eigenständige Arbeit mit der Platine im Labor möglich war. Da zu Hause das notwendige Equipement zum Löten einer SMD-Schaltung nicht vorhanden
war, fuhrte dies zu vielen Verz ¨ | ögerungen. Zum Gluck konnte letztendlich ¨
doch noch die Platine eigenständig im Labor gelötet werden.
Insgesamt haben wir viele neue Erfahrungen gesammelt durch die Ausdauer, die dieses Projekt erfordertet und das dadurch immer tiefere Eintauchen in die Materie.

30

## Abbildungsverzeichnis

1 | Flussdiagramm zum Ablauf des Hauptprogramms | | 5
2 | Zustandsdiagramm | | 6
3 | STM32G031J6M6 als SMD-Baustein QUELLE | | 8
4 | Pinbelegung des Mikrocontrollers STM32G031J6M6 QUELLE | 8
5 | LED Schaltung | 10
6 | Kennlinien forward current vs. forward voltage der unterschied-
lichen SMD-LED’s [1] | 12
7 | RC-Tiefpass | 14
8 | Funktionsweise des Kapazitiven Sensors | 15
9 | Schaltplan | 21
10 | Layout - Front Layer | 24
11 | Layout - Back Layer | 24
12 | 3D gedrucktes Gehäuse | 25
13 | bestellte Broschenadel zur Befestigung [2] | 27
14 | Grundbehältnis des Gehäuses mit Bemaßungen | 28
15 | Deckel des Gehäuses mit Bemaßungen | 29

## Tabellenverzeichnis

1 | LED Schaltung Pinbelegung | 11
2 | Stromverbrauch unterschiedlicher Modi | 18

31

## Literatur

[1] HSMx-A10x-xxxxx, | Avago, | https://www.infinite-
electronic.ru/datasheet/6e-HSMA-A100-Q00H1.pdf.
[2] 10 Broschennadeln selbstklebend, ca. 30mm , Amazon.

32
