Typwithoutname/VMCB/Doku/Version1_Datum_Englisch.pdf

### Optional externes Logo

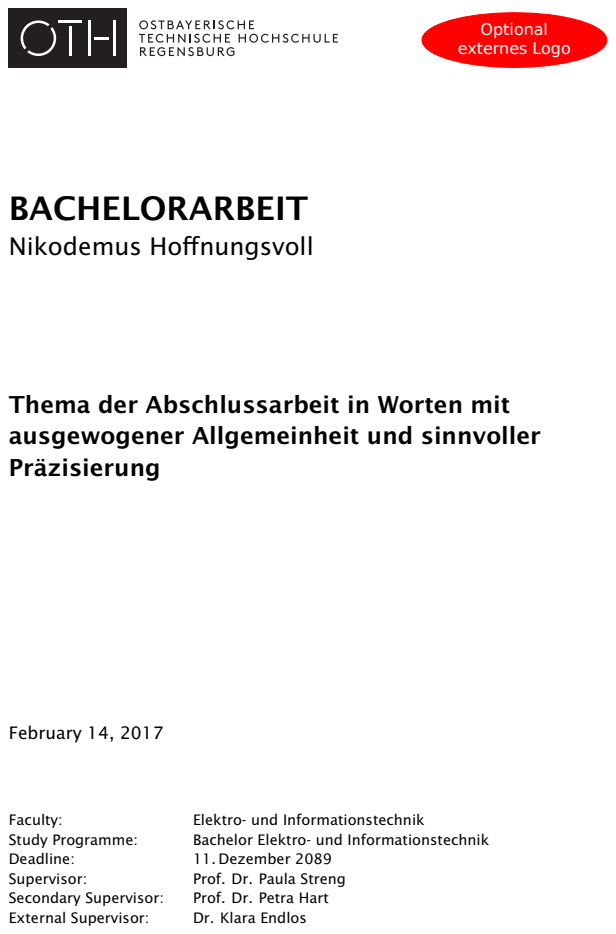
[picture p31: page 1]
BACHELORARBEIT; Nikodemus Hoffnungsvoll; February 14, 2017; Faculty:; Elektro- und Informationstechnik; Study Programme:; Bachelor Elektro- und Informationstechnik; Deadline:; 11. Dezember 2089; Supervisor:; Prof. Dr. Paula Streng; Secondary Supervisor:; Prof. Dr. Petra Hart; External Supervisor:; Dr. Klara Endlos

Thema der Abschlussarbeit in Worten mit
ausgewogener Allgemeinheit und sinnvoller
Präzisierung

## Contents

1 Something | 3
2 Something Else | 3

2

## 1 Something

Hier müsste nun etwas Text stehen, den man sich hierfür erst noch ausdenken müsste, denn man kann ja nicht einfach irgendwas in so ein wichtiges Dokument schreiben.

So ein Abschnitt sollte auch mehrere Absätze besitzen, denn allzu kurze Texte wirken ansonsten etwas ermüdend, manchmal.

## 2 Something Else

Hier müsste nun aber auch etwas Text stehen, den man sich hierfür erst noch ausdenken müsste, denn man kann ja nicht einfach irgendwas in so ein wichtiges Dokument schreiben.

3

Erklärung

1. Mir ist bekannt, dass dieses Exemplar der Bachelorarbeit als Prüfungsleistung in das Eigentum der Ostbayerischen Technischen Hochschule Regensburg übergeht.
2. Ich erkläre hiermit, dass ich diese Bachelorarbeit selbstständig verfasst, noch nicht anderweitig fÃijr Prüfungszwecke vorgelegt, keine anderen als die angegebenen Quellen und Hilfsmittel benutzt sowie wörtliche und sinngemäße Zitate als solche gekennzeichnet habe.

Ort, Datum und Unterschrift

Presented by: | Nikodemus Hoffnungsvoll
Student ID: | 123456789
Study Programme: | Bachelor Elektro- und Informationstechnik
Time Frame: | 1. November 2088 – 11. Dezember 2089
Supervisor: | Prof. Dr. Paula Streng
Secondary Supervisor: | Prof. Dr. Petra Hart
External Supervisor: | Dr. Klara Endlos
