Typwithoutname/VMCB/Doku/FotoGehäuse.jpg

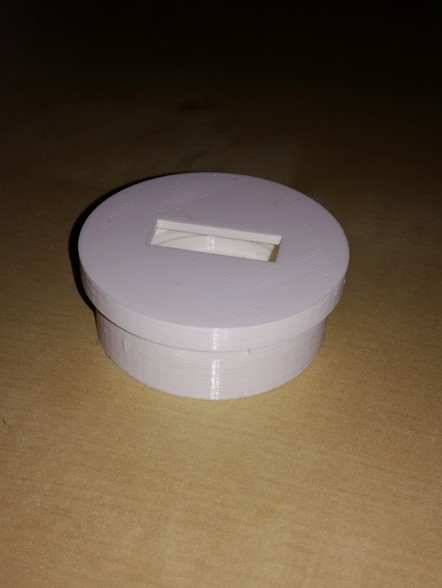
Doku/FotoGehäuse.jpg
