Typwithoutname/VMCB/Doku/GefrästePlatine.jpg

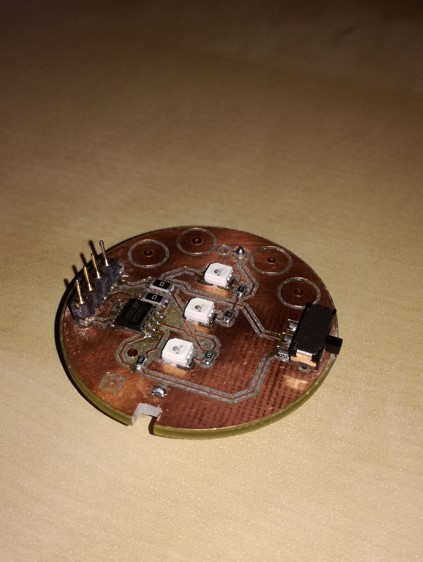
Doku/GefrästePlatine.jpg
