Typwithoutname/VMCB/Doku/Gehauuse_Stimmungslicht.jpg

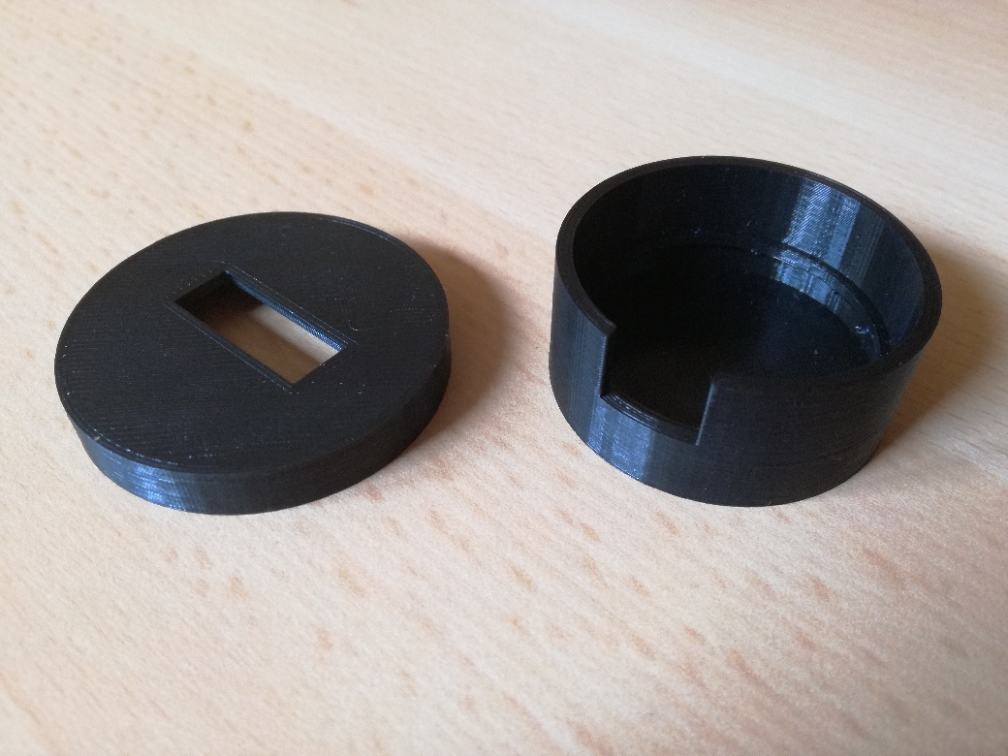
Doku/Gehauuse_Stimmungslicht.jpg
