Typwithoutname/VMCB/Doku/mess-v02-sprungantwort-tiefpass.png

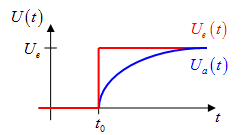
Doku/mess-v02-sprungantwort-tiefpass.png
