Typwithoutname/VMCB/Stimmungslicht 2/Bom_Stimmungslicht.xlsx

ID | Bezeichner | GehÃ¤use | StÃ¼ckzahl | Bezeichnung | Kommentare
1 | S1 | JS102011SAQN | 1 | JS102011SAQN | Schiebeschalter | Dürften in der OTH vorhanden sein
2 | U103,U104,U102,U101 | Touch_Sens_Pad | 4 | Touch_Sens_Pad
3 | U1 | HU2032LF | 1 | HU2032-LF | Batteriehalter | Haben wir bestellt
4 | R102,R101 | R_1206_3216Metric_Pad1.42x1.75mm_HandSolder | 2 | 0 Ohm
5 | JP101 | SolderJumper-3_P1.3mm_Bridged12_RoundedPad1.0x1.5mm | 1 | SolderJumper_3_Bridged12 |  | Benötigt keine Bauteile
6 | IC1 | SOIC127P600X175-8N | 1 | STM32G031J6M6
7 | J1 | PinHeader_1x01_P2.54mm_Vertical | 1 | Conn_01x01 |  | Muss nicht gelötet werden. Wir brauchen ihn aber zum testen
8 | LED1 | LED_PLCC-2 | 1 | red
9 | LED2 | LED_PLCC-2 | 1 | yellow
10 | LED3 | LED_PLCC-2 | 1 | green
11 | R1,R2 | R_0603_1608Metric_Pad1.05x0.95mm_HandSolder | 2 | 120 Ohm
12 | R3 | R_0603_1608Metric_Pad1.05x0.95mm_HandSolder | 1 | 150 Ohm
13 | R4 | R_0603_1608Metric_Pad1.05x0.95mm_HandSolder | 1 | 4.7 MOhm
14 | J2 | PinHeader_1x04_P2.54mm_Vertical | 1 | Conn_01x04_Male
15 |  | R_0603_1608Metric_Pad1.05x0.95mm_HandSolder | 1 | 1 Mohm
