Typwithoutname/VMCB/Gehäuse/deckel_gekuerzt_2.SLDPRT

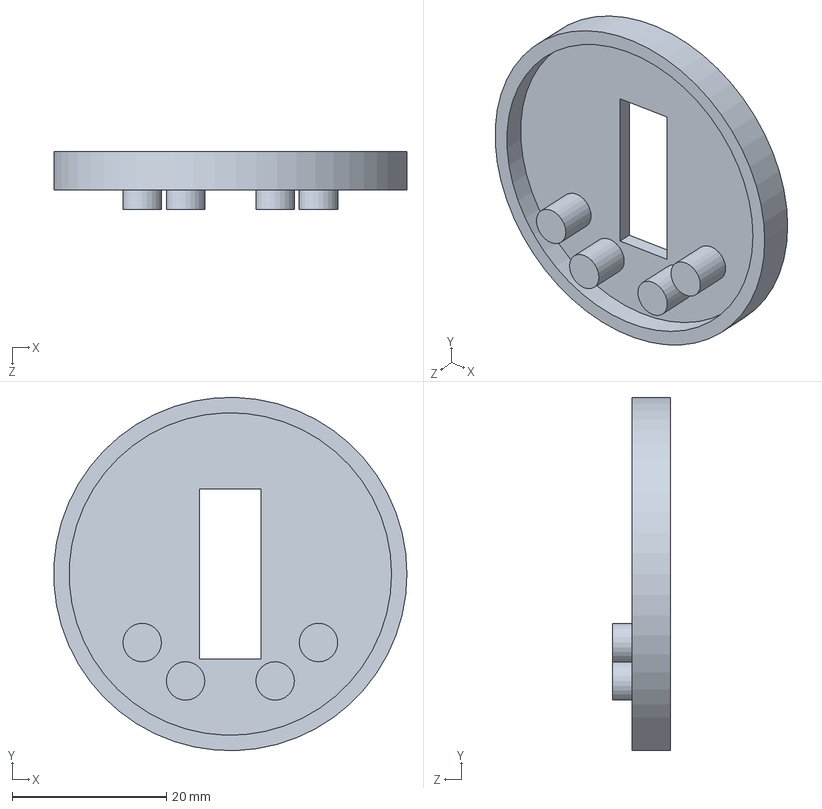
[picture p36: CAD file, 2020-11-08]
Gehäuse/deckel_gekuerzt_2.SLDPRT
45.8 x 45.8 x 7.50 mm
