Typwithoutname/VMCB/Gehäuse/gehäuse_5.SLDPRT

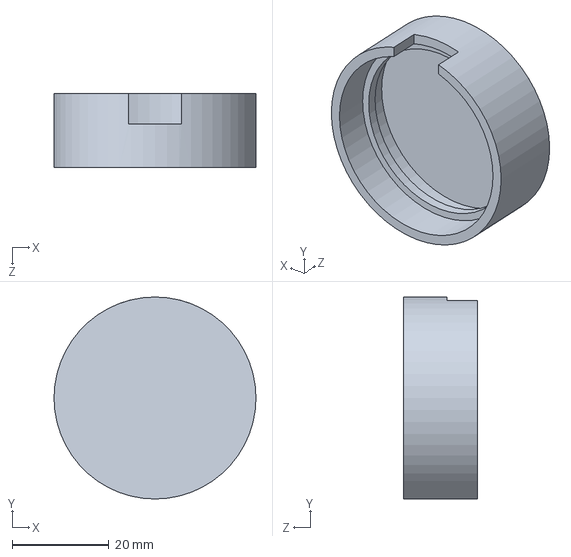
[picture p37: CAD file, 2020-11-07]
Gehäuse/gehäuse_5.SLDPRT
41.8 x 41.8 x 15.3 mm
