Typwithoutname/VMCB/Gehäuse/STL_Dateien/deckel_gekuerzt.STL

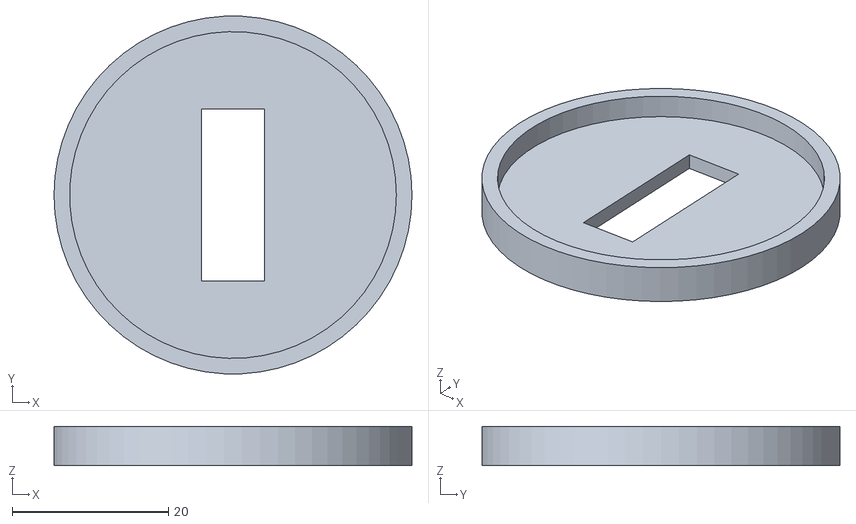
[picture p38: CAD file, 2020-11-08]
Gehäuse/STL_Dateien/deckel_gekuerzt.STL
45.8 x 45.7 x 5.00
