Typwithoutname/VMCB/Gehäuse/deckel.SLDPRT

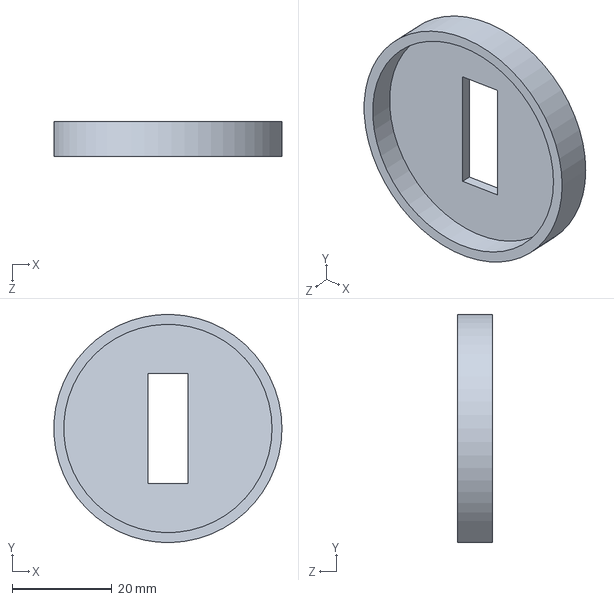
[picture p39: CAD file, 2020-08-06]
Gehäuse/deckel.SLDPRT
45.8 x 45.8 x 7.00 mm
