Typwithoutname/VMCB/Gehäuse/gehäuse_2.SLDPRT

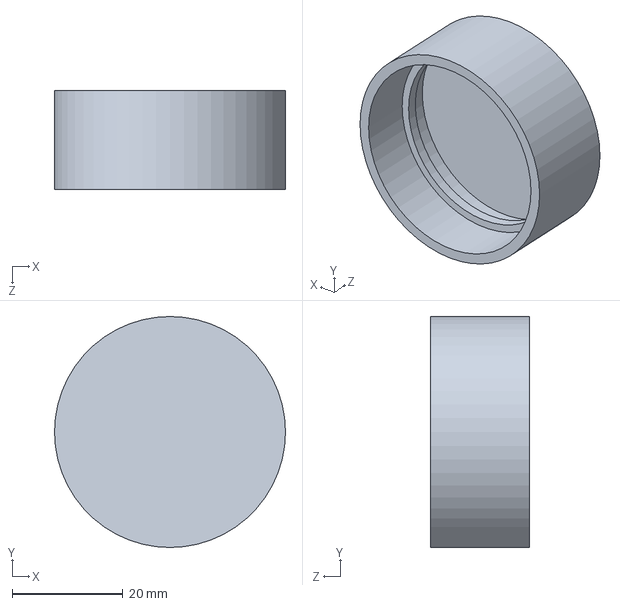
[picture p40: CAD file, 2020-08-06]
Gehäuse/gehäuse_2.SLDPRT
41.8 x 41.8 x 18.0 mm
