Typwithoutname/VMCB/(list of files, cad)

Other CAD files:
Gehäuse/STL_Dateien/deckel_gekuerzt_2.STL
Gehäuse/deckel_gekuerzt.SLDPRT
Gehäuse/STL_Dateien/gehäuse_5.STL
