Typwithoutname/VMCB/Doku/deckel.pdf

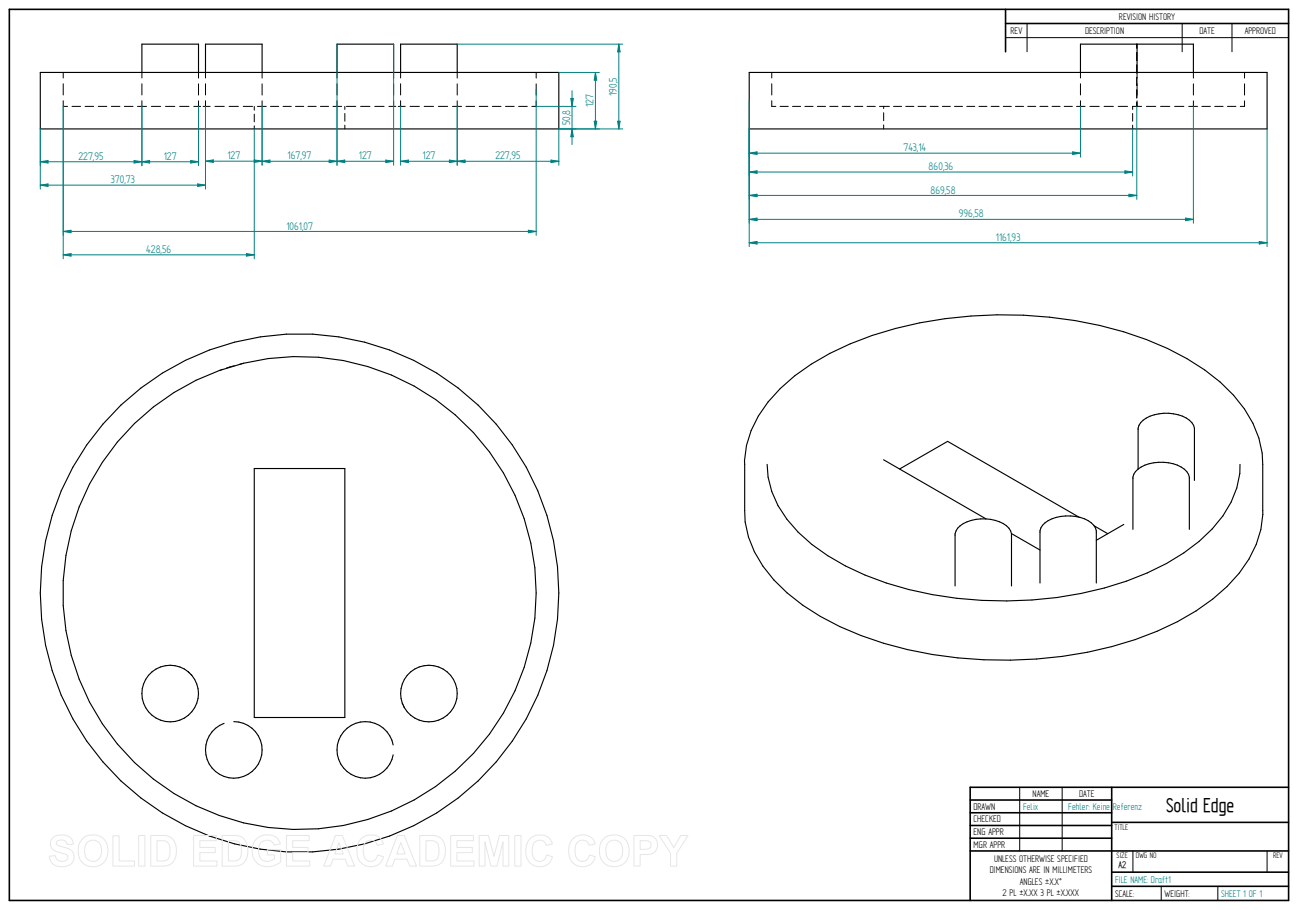
[picture p41: page 1]
TITLE; FILE NAME: Draft1; SCALE:; WEIGHT:; SHEET 1 OF 1

REVISION HISTORY

REV | DESCRIPTION | DATE | APPROVED

NAME | DATE | Solid Edge

DRAWN | Felix | Fehler: Keine Referenz
CHECKED
ENG APPR
MGR APPR
UNLESS OTHERWISE SPECIFIED DIMENSIONS ARE IN MILLIMETERS ANGLES ±X.X° 2 PL ±X.XX 3 PL ±X.XXX | SIZE A2 | DWG NO | REV
