Typwithoutname/VMCB/Doku/Schaltplan.pdf

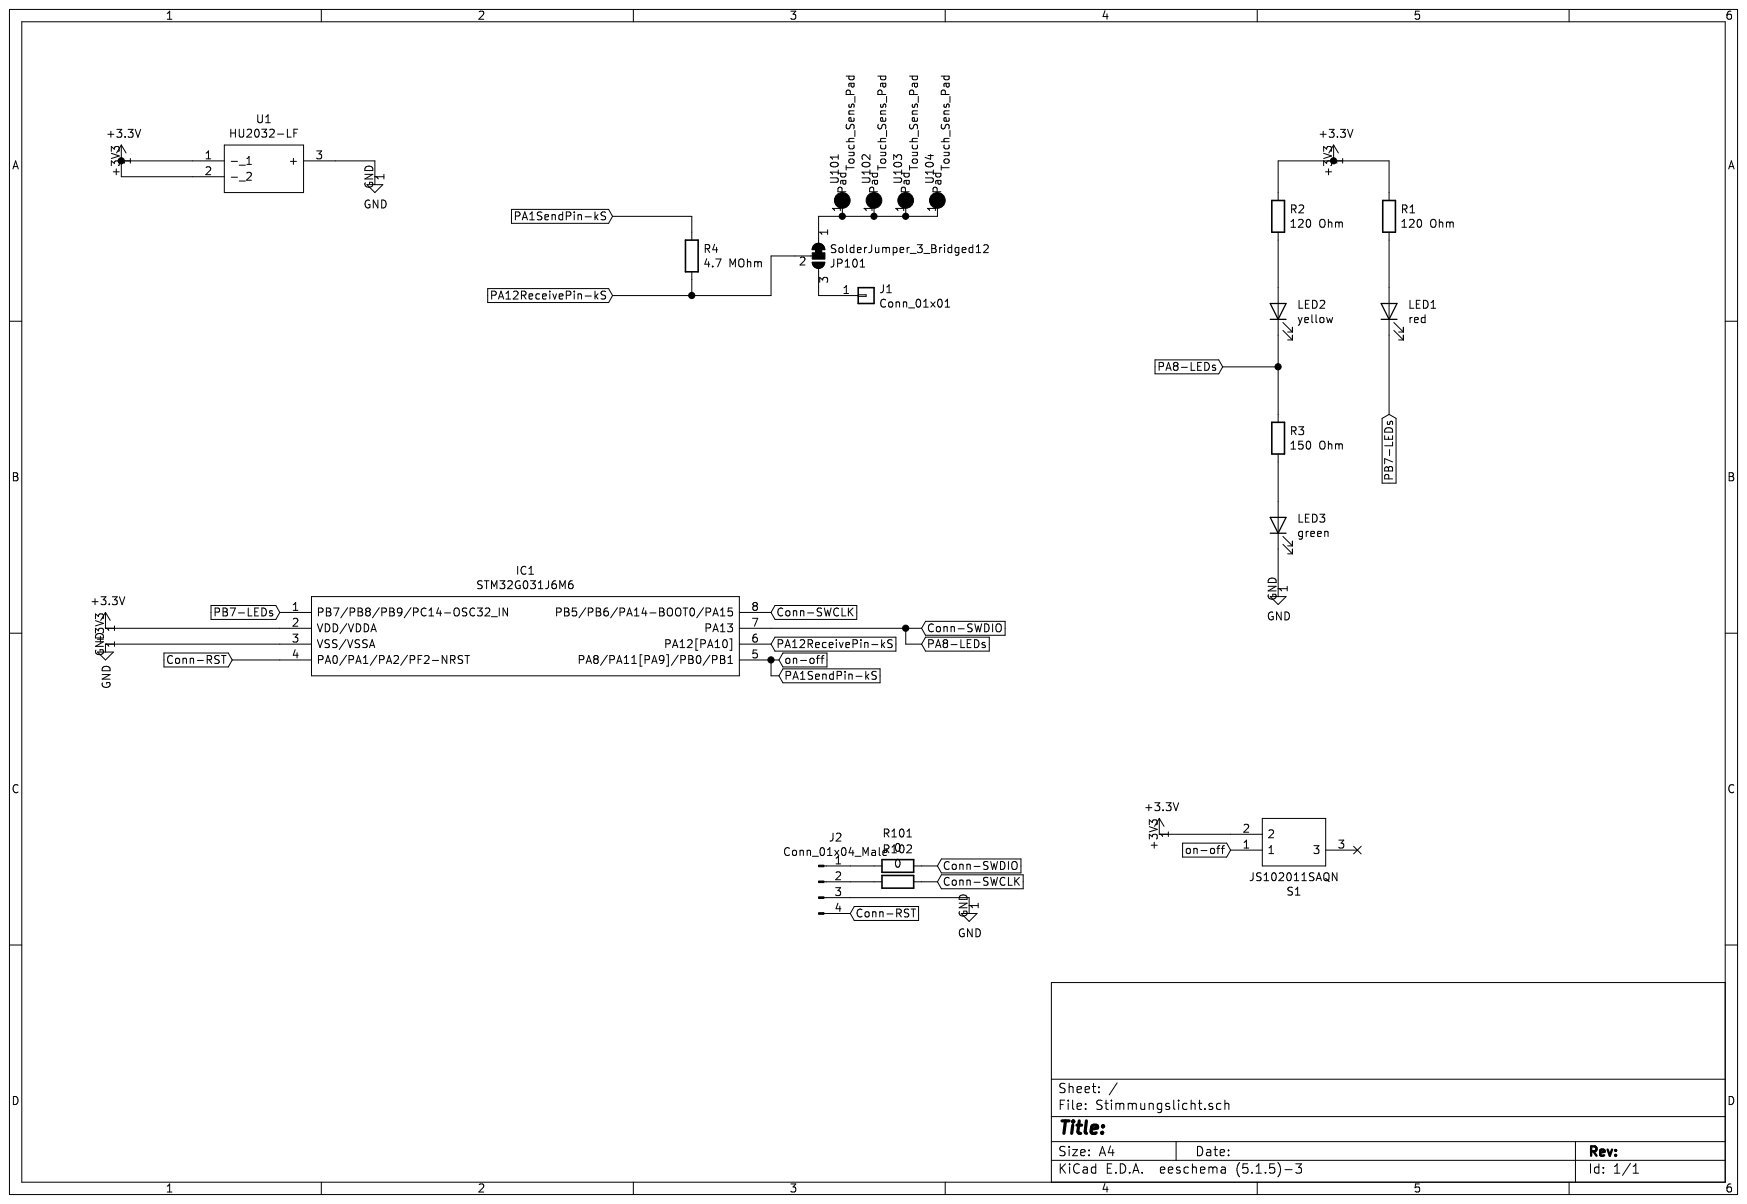
[picture p42: page 1]
