Typwithoutname/VMCB/Testprogramm/shit/Core/Src/main.c

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

/* Includes ------------------------------------------------------------------*/
#include "main.h"

ADC_HandleTypeDef hadc1;

void SystemClock_Config(void);
static void MX_GPIO_Init(void);
static void MX_ADC1_Init(void);
/**
  * @brief  The application entry point.
  * @retval int
  */
int main(void)
{
  /* MCU Configuration--------------------------------------------------------*/

  /* Reset of all peripherals, Initializes the Flash interface and the Systick. */
  HAL_Init();

  /* Configure the system clock */
  SystemClock_Config();

  /* Initialize all configured peripherals */
  MX_GPIO_Init();
  MX_ADC1_Init();
  /* USER CODE BEGIN 2 */
  int value1=GPIO_PIN_SET;
  int value2=GPIO_PIN_RESET;
  uint16_t raw=0;
  /* USER CODE END 2 */

  /* Infinite loop */
  /* USER CODE BEGIN WHILE */
  while (1)
  {
	  //HAL_GPIO_TogglePin(GPIOA, GPIO_PIN_2);
	  //HAL_Delay(500);
	  //int value=HAL_GPIO_ReadPin(GPIOx, GPIO_Pin)
	  HAL_ADC_Start(&hadc1);
	  HAL_ADC_PollForConversion(&hadc1, HAL_MAX_DELAY);
	  raw=HAL_ADC_GetValue(&hadc1);
    /* USER CODE END WHILE */

    /* USER CODE BEGIN 3 */
  }
  /* USER CODE END 3 */
}

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
