Typwithoutname/VMCB/Testprogramm/shit/shit.ioc

Mcu.UserName=STM32G031J6Mx
PA2.Signal=SharedAnalog_PA2
