Typwithoutname/VMCB/(commit log)

2020-04-03 Datenblaetter und Erste Hilfsmittel hinzugefügt
2020-04-03 Updaten des Git Guides
2020-04-18 Code für LED-Taster und Registerbeschreibung
2020-05-28 Datenblatt für die LEDs mit Datenleitung
2020-05-28 Datenblatt RGB LED mit 3 Anschlüssen
2020-06-16 Kapazitiver Sensor
    [try Debug.cfg]
2020-06-24 Diodenschaltung Programmcode
2020-06-24 Schaltplan fertig, Layout Bauteile eingefügt
    [Schaltplan.kicad_pcb, Schaltplan.sch]
2020-06-29 ersten Leiterbahnen gezogen
    [Schaltplan.kicad_pcb, Schaltplan.sch]
2020-06-30 Leiterbahnen gezeichnet
    [Schaltplan.kicad_pcb]
2020-07-01 Schaltplan fertig Mi. 1.7.
    [Schaltplan.kicad_pcb]
2020-07-01 Eine Leitung minimal bewegt um eine Warnung zu beheben
    [Schaltplan.kicad_pcb]
2020-07-01 mit button Kupfer und Design Check
    [Schaltplan.kicad_pcb, Schaltplan.sch]
2020-07-01 Bottom GND hinzugefügt
    [Schaltplan.kicad_pcb]
2020-07-08 Datenblatt SMD LED
2020-07-08 erster Schaltplan mit SMD
    [Schaltplan.kicad_pcb, Schaltplan.sch]
2020-07-15 PCB fertig ohne Schalter
    [Schaltplan.kicad_pcb, Schaltplan.sch]
2020-07-15 Sensorpads hinzugefügt
    [Schaltplan.kicad_pcb]
2020-07-15 mit Sensor, Platine fertig
    [Schaltplan.kicad_pcb, Schaltplan.sch]
2020-07-21 Schaltplan Farmbauer
    [Stimmungslicht.kicad_pcb, Stimmungslicht.sch]
2020-07-22 Widerstandswerte korrekt
    [Stimmungslicht.sch]
2020-08-04 Konataktierungen ergäntzt
    [Bom_Stimmungslicht.xlsx, Stimmungslicht.kicad_pcb]
2020-08-06 erste Zeichnung Gehäuse
    [deckel.SLDPRT, gehäuse_2.SLDPRT]
2020-08-13 Gehäuse fertig?
    [gehäuse_4.SLDPRT]
2020-09-24 Pin Veränderungen durchgeführt
    [Bom_Stimmungslicht.xlsx, Stimmungslicht.kicad_pcb, Stimmungslicht.sch]
2020-09-24 Code auf neue Pinbelegung angepasst
    [niipnnp Debug.cfg]
2020-10-18 Sensorflaechen angepasst
    [Stimmungslicht.kicad_pcb]
2020-10-18 Schaltplan umgesetzt
    [Stimmungslicht.kicad_pcb]
2020-10-18 Deckel gekürzt
    [deckel_gekuerzt.SLDPRT]
2020-10-20 Doppelt Durchführungen entfernt
    Einige Warnungen behoben
    [Stimmungslicht.kicad_pcb]
2020-11-05 Aktueller Schaltplan
    [Stimmungslicht-B_Cu.gbr, Stimmungslicht-B_Mask.gbr, Stimmungslicht-B_Paste.gbr, Stimmungslicht-B_SilkS.gbr, Stimmungslicht-Edge_Cuts.gbr, Stimmungslicht-F_Cu.gbr, Stimmungslicht-F_Mask.gbr, Stimmungslicht-F_Paste.gbr]
2020-11-07 Gehäuse verkürzt und Deckel mit Zylindern für Pads
    [deckel_gekuerzt_2.SLDPRT, gehäuse_4.SLDPRT, gehäuse_5.SLDPRT]
2020-11-08 STL-Dateien hinzugefügt
    [deckel_gekuerzt.STL, deckel_gekuerzt_2.SLDPRT, deckel_gekuerzt_2.STL, gehäuse_5.STL]
2020-12-29 Schaltplan und Layout abgeschlossen, Überarbeitung Gehäuse-Bilder fehlt
2020-12-30 Änderung an Zeichnungen und Quellen für Bilder hinzugefügt
